StandardJun/KIH-Keyboard-In-my-Hand/analysis/STUDY_DESIGN.md

사용자 실험 설계
RESULTS.md의 수치를 만들어 낸 실험의 설계·절차·지표 정의. 재현하거나 후속 실험을 붙일 때 이 문서를 기준으로 한다.

연구 질문
새 입력 방식은 초기에 느릴 수밖에 없다. 따라서 물어야 할 것은 "지금 빠른가"가 아니라 "학습되는가, 그리고 언제 기존 방식을 넘어서는가" 이다.

KIH의 입력 속도는 반복 시행에 따라 유의하게 증가하는가
속도 향상이 정확도 희생으로 얻어지는 것은 아닌가 (속도-정확도 트레이드오프)
같은 조건에서 기존 대안(커서 선택식 화면 키보드)과 비교하면 어디서 교차하는가
설계
항목
내용
설계
참가자 내 설계(within-subject), 두 조건 모두 수행
참가자
20명
조건
① KIH(장갑형 키보드) ② TV OSK(방향키 커서 이동 + 선택식 화면 키보드)
순서 통제
조건 순서를 참가자 간 균형 배치(counterbalancing)
훈련
조건별 10분
본 시행
1분 입력 × 15회 반복
과제
300개 단어 풀에서 무작위 제시된 단어 입력
시각 조건
기기를 보지 않은 채 입력
대조군으로 커서 선택식을 고른 이유: 스마트TV·XR에서 실제로 가장 널리 쓰이는 문자 입력 방식이고, KIH와 마찬가지로 물리 자판 없이 동작하므로 "책상 없는 환경"이라는 조건이 같기 때문이다.

도구
조건
도구
KIH
experiments/speed_test.py
TV OSK
experiments/tv_remote_sprint.py
두 도구는 같은 단어 풀, 같은 60초, 같은 WPM 정의를 쓴다. 그래야 두 조건의 수치를 그대로 나란히 놓을 수 있다. 각 시행은 logs/ 아래 JSONL(시행별 원본)과 누적 CSV(시행별 요약)로 동시에 저장된다.

측정 시작 시점은 첫 조작(KIH는 첫 키 입력, TV OSK는 첫 방향키 이동 또는 선택)이다. 커서를 목표 키까지 옮기는 시간은 그 방식의 핵심 비용이므로, 첫 선택 부터 재면 대조군에 유리하게 왜곡된다.

지표
속도 — 국제 비교를 위해 표준 정의를 따른다.

WPM = (자모 수 / 분) / 5
한글은 음절 단위와 자모 단위가 달라 CPM(음절/분)도 함께 기록하지만, 문헌 비교에는 WPM을 쓴다.

정확도 — 두 조건의 정의가 다르므로 추세 비교에 한정하고 직접 대소 비교는 하지 않는다.

조건
지표
정의
KIH
미수정 오류율
MSD(목표 자모열, 입력 자모열) / max(길이) × 100
TV OSK
수정률
(선택 횟수 − 자모 수) / 자모 수 × 100
TV OSK는 단어가 정확히 맞아야 다음으로 넘어가는 구조라 오타가 결과 문자열에 남지 않는다. 그래서 "틀려서 더 누른 만큼"을 교정 비용으로 환산해 정확도 대용 지표로 삼았다.

설계값 재현 확인 — 백스페이스와 제출 키를 제외한 보정 KSPC를 계산해, 말뭉치 분석에서 설계한 KSPC 1.27이 실사용에서도 재현되는지 확인한다.

학습 효과 분석
연습의 멱법칙(Power Law of Practice)을 적용해 시행 횟수 n에 대한 속도를 회귀한다.

WPM = a · n^b        (양변에 log를 취해 선형 회귀)
b(학습 지수)가 크고 유의하면 반복으로 개선되는 방식
b ≈ 0이면 첫 접촉부터 이미 포화된 방식
적합도는 R²로 평가
두 조건의 적합 결과는 RESULTS.md에 있다. 요지는 지수 0.602 대 0.079 — 같은 15회 시행에서 한쪽만 학습되었다는 뜻이다.

한계와 후속 과제
15회 시행(약 15분)은 학습곡선의 초기 구간만 관측한 것이다. 30·50회 수치는 적합식 외삽이며 실측이 아니다.
참가자는 모두 커서 선택식을 이미 경험한 상태였다. 대조군의 낮은 학습 지수는 이 사전 경험을 반영한다.
두 조건의 정확도 지표 정의가 달라 직접 비교하지 않았다. 동일 정의로 재측정하려면 KIH에도 "정확히 맞아야 다음 단어" 규칙을 넣거나, TV OSK에서 오타 통과를 허용해야 한다.
자세 조건(착석/와상/기립)과 시각 차단 강도별 비교는 experiments/PROTOCOL.md의 실험 C·E로 설계되어 있으나 본 실험에는 포함하지 않았다.
시각장애 당사자 대상 평가는 수행하지 않았다. 접근성 활용을 주장하려면 별도 검증이 필요하다.
