StandardJun/KIH-Keyboard-In-my-Hand/analysis/COST_MARKET.md

원가 구조와 가격 분석
프로토타입 재료비에서 출발해 양산 시 조달원가, 그리고 시장 구조를 반영한 권고 소비자가격까지.

1. 프로토타입 재료비 — 14,184원
메커니즘 검증이 목적이었으므로 표준 범용 부품만 썼다. 촉감 좋은 스위치·경량 장갑·무선화 모듈은 매핑 메커니즘과 독립적으로 교체 가능한 계층이라 개선 계획으로 분리했다.

품목	규격	수량	단가(원)	금액(원)
택트 스위치	6×6mm, 4핀	16	134	2,144
마이크로컨트롤러	Arduino Leonardo (ATmega32u4)	1	8,500	8,500
장갑	가죽, 좌우 1쌍	2	1,000	2,000
배선재	단선 케이블, 열수축 튜브	1식	1,040	1,040
기타	접착제, 절연 테이프 등	1식	500	500
합계				14,184
원가의 60%가 마이크로컨트롤러 하나다. 소형 PCB로 32u4를 직접 실장하면 이 항목이 가장 크게 줄어든다.

2. 규모의 경제 — 15대 이상에서 12,230원
이 제품은 같은 버튼과 배선을 반복해서 쓰기 때문에, 생산량이 늘면 설비 투자 없이 조달 조건만으로 단가가 내려간다. 버튼 스위치 수량 할인과 케이블 롤 단위 구매를 반영하면:

재료비
1대 소량 구매
14,184원
약 15대 이상
12,230원
절감
1,954원/대 (13.8%)
15대 부근에서 수렴하며 이후로는 큰 변화가 없다. 설비 자동화가 아니라 구매 수량에서 오는 조달 측면의 규모의 경제(procurement economies of scale)다.

3. 시장 구조 — 고집중이지만 입력 방식은 경쟁적
본 제품의 주요 활용 환경 중 하나는 책상과 물리 입력면이 제한되는 XR이다. Counterpoint Research 기준 Meta는 2026년 1분기 글로벌 XR 출하량의 58%를 차지한다.

그러나 플랫폼 집중도가 곧 우리 제품의 가격결정력은 아니다. 사용자는 문자 입력에 컨트롤러, 핸드트래킹, 가상 키보드, 음성, 블루투스 키보드 등 여러 대체 수단을 고를 수 있다. 따라서 본 제품은 가격에 민감한 선택재로 보는 것이 타당하다.

4. 권고 소비자가격 — 34,900원
BOM은 판매가가 아니다. 조립·기능검사·포장 등 단위 변동비를 얹어 한계비용(MC)을 근사한 뒤, 탄력적 수요를 가정한 마크업 가격 모형을 적용했다.

단계
계산
① 직접재료비(BOM)
12,230원
② 한계비용 근사
MC = 12,230 × 1.20 = 14,676원
③ 최적가격 모형
P* = ε / (ε − 1) × MC
④ Base Case (ε = 1.75)
P* = (1.75 / 0.75) × 14,676 ≈ 34,244원
⑤ 권고 소비자가
34,900원
ε = 1.75는 시장 점유율에서 추정한 실증치가 아니라 가격 전략을 위한 Base Case 가정이다. 대체 수단이 많은 선택재이므로 수요가 탄력적인 영역(ε > 1)에 둔 것이다.

탄력성 민감도
실판매 전에는 ε를 정확히 추정할 수 없으므로 단일 숫자보다 범위로 본다(MC = 14,676원 고정).

ε
이론상 P*
해석
1.50
44,028원
가격민감도가 상대적으로 낮은 경우
1.75 (Base)
34,244원
권고가 34,900원의 기준
2.00
29,352원
가격민감도가 상대적으로 높은 경우
경쟁 제품 대비 위치
제품
가격
KIH (권고가)
34,900원
Tap Strap 2
$99
Twiddler 3
$199
CharaChorder
$200~300
기존 웨어러블 키보드 가격대(약 13만40만 원)의 3분의 1 이하다. 참고로 이 시장의 대표 실패 사례인 DataHand($995)의 단종 요인이 고비용이었다는 점은 저가 전략의 역사적 근거가 된다.

또한 XR 기기 자체가 이미 고가다(Quest 3S·Quest 3 국내 판매가 약 55만~95.7만 원). 본 장치는 기존 기기에 얹는 저비용 액세서리이므로 추가 구매 부담이 낮다.

5. 한계
34,900원은 양산 안정화 이후 목표가이며, 현재 프로토타입 원가에 조립 인건비는 포함돼 있지 않다.
ε는 가정값이다. 실제 사업화 단계에서는 구매의향 조사나 A/B 가격실험으로 재추정해야 한다.
12,230원은 15대 기준 조달가로, 수백 대 이상 규모의 단가는 별도 견적이 필요하다.
시각장애인 보조기기 채널(정보통신보조기기 보급사업 등)은 별도의 가격·인증 요건이 있어 일반 소비자가와 다르게 접근해야 한다.
출처: Counterpoint Research (2026) Global XR Market Share · Omdia (2026) XR headwear market · 부품 단가는 2025~2026년 국내 유통가 조사 기준.
