StandardJun/KIH-Keyboard-In-my-Hand/experiments/word_list_ko.txt

# word_list_ko.txt — 한글 타자 속도 실험용 단어 목록 (300개)
# 한 줄에 1단어. '#'로 시작하는 줄은 주석으로 무시됨.
# 구성: 일상 어휘, 2~4음절 명사/동사 위주.
# 쌍자음(ㄲㄸㅃㅆㅉ)·겹받침 포함 단어를 약 10% 섞어 자모 다양성 확보.

# --- 사람/가족 ---
사람
친구
가족
부모님
어머니
아버지
동생
언니
오빠
누나
할머니
할아버지
삼촌
이모
이웃
아기
어른
아이

# --- 학교/공부 ---
학교
학생
선생님
교실
책상
의자
연필
볼펜
지우개
공책
교과서
사전
숙제
시험
성적
방학
수업
질문
대답
발표
도서관
공부

# --- 음식 ---
사과
딸기
포도
수박
복숭아
바나나
오렌지
감자
고구마
당근
양파
마늘
배추
호박
김치
라면
국수
냉면
비빔밥
김밥
만두
떡볶이
두부
계란
우유
과자
사탕
초콜릿
케이크
커피
주스
생선
새우
오징어
소고기
닭고기
쌀밥
찌개

# --- 집/생활 ---
침대
베개
이불
창문
거울
시계
달력
지갑
가방
우산
신발
양말
모자
장갑
안경
바지
치마
주머니
부엌
거실
화장실
계단
마당
열쇠
청소
빨래
설거지

# --- 자연 ---
하늘
구름
태양
바다
강물
호수
들판
나무
바위
모래
파도
무지개
천둥
번개
얼음
햇살
계절
여름
가을
겨울
봄바람
눈사람
빗방울
꽃잎
풀잎
숲길

# --- 동물 ---
강아지
고양이
토끼
코끼리
호랑이
사자
여우
다람쥐
고래
거북이
개구리
참새
비둘기
독수리
까치
까마귀
꿀벌
나비

# --- 교통/장소 ---
지하철
버스
기차
비행기
자동차
자전거
오토바이
택시
정류장
공항
다리
건물
아파트
병원
약국
시장
가게
식당
극장
공원
놀이터
은행
회사
사무실
우체국
도시

# --- 몸/건강 ---
머리
얼굴
눈썹
입술
어깨
손목
손가락
발가락
무릎
허리
가슴
심장
건강
감기
기침
치료
운동

# --- 추상/시간 ---
마음
사랑
행복
슬픔
기쁨
걱정
희망
용기
경험
기억
추억
약속
비밀
이야기
문제
정답
생각
시간
아침
저녁
새벽
오후
어제
오늘
내일
주말

# --- 사물/미디어 ---
컴퓨터
휴대폰
전화
편지
신문
뉴스
광고
인터넷
게임
화면
자판
마우스
노트북
카메라
사진
그림
음악
노래
영화
라디오
텔레비전

# --- 활동/운동 ---
축구
야구
농구
수영
등산
낚시
산책
달리기
줄넘기
여행
요리
운동장
운동화
태권도

# --- 동사 ---
먹다
마시다
달리다
자다
일어나다
씻다
입다
쓰다
읽다
배우다
가르치다
놀다
웃다
말하다
듣다
보다
만나다
기다리다
찾다
잃다
주다
받다
사다
팔다
앉다
그리다
만들다
고치다

# --- 쌍자음/겹받침 보강 ---
아빠
뿌리
짜장면
땅콩
쓰레기
꿈꾸다
많다
짧다
넓다
밝다
젊다

# --- 일반 어휘 보충 ---
소풍
노을
항구
골목
목소리
인형
지도
저금통
