StandardJun/KIH-Keyboard-In-my-Hand/experiments/logs/speed_vs_tv_all.csv

timestamp | participant | device | session | posture | trial | words_completed | syllables | jamo | cpm_syl | jpm | wpm | key_events | backspace | msd_error_pct | skips | presses | moves | backspaces | moves_per_press | correction_pct
2026-07-11T16:26:07 | P1 | KIH | S1 | desk | 1 | 2 | 5 | 11 | 5 | 11 | 2.2 | 31 | 2 | 0
2026-07-11T16:27:43 | P1 | KIH | S1 | desk | 2 | 1 | 6 | 17 | 6 | 17 | 3.4 | 39 | 3 | 0
2026-07-11T16:29:02 | P1 | KIH | S1 | desk | 3 | 4 | 9 | 23 | 9 | 23 | 4.6 | 41 | 0 | 0
2026-07-11T16:30:19 | P1 | KIH | S1 | desk | 4 | 2 | 7 | 15 | 7 | 15 | 3 | 47 | 4 | 0
2026-07-11T16:31:44 | P1 | KIH | S1 | desk | 5 | 2 | 7 | 18 | 7 | 18 | 3.6 | 38 | 2 | 0
2026-07-11T16:32:53 | P1 | KIH | S1 | desk | 6 | 4 | 10 | 28 | 10 | 28 | 5.6 | 51 | 2 | 0
2026-07-11T16:34:03 | P1 | KIH | S1 | desk | 7 | 1 | 4 | 8 | 4 | 8 | 1.6 | 20 | 2 | 0
2026-07-11T16:35:11 | P1 | KIH | S1 | desk | 8 | 4 | 8 | 22 | 8 | 22 | 4.4 | 56 | 3 | 4.55
2026-07-11T16:36:18 | P1 | KIH | S1 | desk | 9 | 4 | 10 | 26 | 10 | 26 | 5.2 | 54 | 3 | 0
2026-07-11T16:37:25 | P1 | KIH | S1 | desk | 10 | 4 | 9 | 23 | 9 | 23 | 4.6 | 50 | 2 | 0
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
