StandardJun/KIH-Keyboard-In-my-Hand/(commit log)

2025-11-28 Import the Mechatronics course prototype
    The sketch as it stood for the Mechatronics course project, preserved
    verbatim. Sixteen buttons on the finger joints, one tap per base jamo
    and a second or third tap to walk the Hunminjeongeum derivation, driving
    the host over USB HID so the OS IME composes the syllables.
    This version resolves a tap only by comparing against a fixed 300 ms
    double-tap window, has no debounce, and stores nothing, so the timing
    had to suit whoever wrote it. Everything that follows in this repository
    starts from here; the file is kept unchanged as the reference point.
    [sketch_nov28a.ino]
2026-07-02 Rebuild the prototype into a measurable project
    The course sketch worked, but nothing about it could be checked: the
    mapping lived in comments, its cost was never measured, and typing speed
    was an impression rather than a number.
    Rewrites the firmware with debounce and a persisted tap window, states
    the mapping as machine-readable JSON so the tools and the device cannot
    disagree, and adds the corpus analysis that puts a figure on what the
    learnability-first layout costs — KSPC 1.269 against 1.727 for a layout
    that ignores jamo frequency, because Hangul's base letters happen to be
    its frequent ones. Adds the experiment protocol with its logging and
    analysis tools, and the figures the repor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
    [calibrate_window.py, keyboard_glove.ino]
2026-07-04 Document the glove wiring and pin map
2026-07-06 Add the hardware build guide
    Documents building the glove from scratch: the bill of materials, why the
    board has to be a 32u4 part (native USB HID, so the host IME composes the
    syllables and no driver is needed), where the sixteen buttons go, and the
    assembly order with a symptom-to-cause table for bring-up.
    Switches are set with double-sided tape to place them, then bonded with
    adhesive so repeated presses do not shift them — a switch that rocks on the
    curved joint blurs the click, which is the confirmation signal eyes-free
    typing relies on. Wiring runs over the back of the hand; across the palm it
    would be pressed when gripping something or making a fist.
    Button placement and the jamo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
2026-07-08 Calibrate the tap window per user and write it into the sketch
    How long the firmware waits before deciding a tap sequence has ended is
    the one setting that has to match the person wearing the glove: too
    short and a double tap splits into two letters, too long and every
    letter lags. It was a hard-coded constant.
    Calibration now measures the user's own inter-tap intervals in raw-tap
    mode, picks the threshold that minimises misclassification between
    deliberate multi-taps and separate letters, and patches
    keyboard_glove.ino directly, so the measured value lives in the source
    rather than only in volatile EEPROM. CAL_STAMP lets a newer source
    value override what a board already has stored.
    [calibrate_window.py, keyboard_glove.ino]
2026-07-13 Split calibration into a standalone tool beside the firmware
    Calibration had grown inside speed_test.py, which left one file doing
    two jobs: measuring typing performance and configuring the device. They
    are run by different people at different times.
    tap_calibration.py now lives next to the sketch it edits, takes a user
    ID with no session concept (the tap window is a property of the person,
    not of a sitting), locates mapping.json without assuming the repo
    layout, and keeps a copy of mapping.json in its own folder so it runs
    standalone. Because that copy can drift, the tool compares every
    mapping.json it can find and warns when they differ — a silent mismatch
    would build measurement senten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
    [calibrate_window.py, keyboard_glove.ino, tap_calibration.py]
2026-07-15 Commit a tap sequence as soon as no further tap can extend it
    Adds a host test that stubs the Arduino API, includes the sketch and
    drives it on a virtual clock, so tap timing can be checked without
    hardware. It found that the max-tap early commit never applied to the
    first tap of a sequence, so Backspace (max 1 tap) waited a full window
    before firing; the check now runs after both branches.
    Also turns EARLY_COMMIT on by default: a pending tap's content is
    already decided, so flushing it when another button is pressed only
    moves the commit earlier, and 96.4% of adjacent jamo pairs in the
    corpus use a different button. The test shows it additionally fixes
    ㄱ+ㅏ+ㄱ typed quickly, which othe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
    [keyboard_glove.ino]
2026-07-20 Track the study's raw logs instead of ignoring them
    The tooling is finished and the study starts now, so the per-trial records it
    writes should live in the repository rather than on whoever ran the session.
    experiments/logs/ was ignored while the tools were being built, when the only
    files landing there were throwaway runs from testing the harness. From here
    the same path holds the measurements the results are computed from, and
    publishing the figure without the data behind it makes the numbers
    unreproducible.
    Participants must be pseudonymous before anything is committed: identify
    people as P01…Pnn and record elapsed time rather than wall-clock timestamps.
2026-07-28 Publish the study's raw per-trial records
    600 rows: 20 participants x 2 conditions x 15 trials, a pilot pair on
    2026-07-11 and the main run from 07-21 to 07-26. Participants are recorded as
    P1..P20; no names, contact details or demographics were collected.
    The two conditions carry different columns because different things are
    countable. KIH logs uncorrected error against the target jamo string, while
    the cursor keyboard advances only on an exact match, so mistakes never survive
    in the output — what it can report is how many extra presses a word cost. The
    data dictionary spells this out, along with why the two accuracy numbers are
    not compared to each other.
    Adds analysis/verify_results.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
    [speed_vs_tv_all.csv]
2026-08-11 Publish the study results and the final project identity
    The 20-participant study is done, so the README leads with it: KIH goes
    2.3 -> 10.6 WPM over 15 one-minute trials (power law n^0.602) while the
    cursor-keyboard baseline stays flat at 5.6 -> 7.5 (n^0.079), and
    uncorrected errors fall 17.2% -> 4.1% with no speed-accuracy trade-off.
    analysis/RESULTS.md is rewritten around the measured data instead of
    the pilot numbers.
    Adds the team (손보드 / HandBoard) and the Mechatronics Competition
    grand prize, and a Korean README — the report cites this page and its
    readers are Korean; both versions carry the same numbers and link to
    each other. The festival is still in its preliminary round, s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
2026-09-30 Add KIH-XR: the same multi-tap layout on camera hand tracking
    Also record the Creative Design Festival bronze prize.
